wjblanke/moviecart/firmware/stm32/src/update.c

#include <string.h> // memset
#include "defines.h"
#include "osd.h"
#include "update.h"
#include "moviecart_yield.h"
#include "bus_service.h"

// transport controls

#define OSD_FRAMES		180
#define BACK_SECONDS	10

#define COLOR_BLACK		0x00
#define COLOR_BLUE		0x9A

#define LABEL_HEIGHT	14
#define LEVEL_HEIGHT	8
#define	TIMECODE_HEIGHT	12

// state machine
#define MODE_TIME       0
#define MODE_VOLUME     1
#define MODE_BRIGHT     2
#define MODE_LAST       MODE_BRIGHT	// last selectable mode; 3 was a dead mode (volume label, no controls)

#define MAX_LEVEL       11
/*
 * Fast-forward/rewind ceiling in fields per frame (speed climbs 1, 5, 9 ... 125
 * while the joystick is held). Each frame's forward seek runs inside the
 * RamKernel window; at 125 it costs at most about one FAT sector read.
 */
#define MAX_SPEED       125
#define DEFAULT_LEVEL   6

/*
 * Volume/brightness left-right: step on the first frame the stick is pushed,
 * then auto-repeat after LEVEL_REPEAT_DELAY frames every LEVEL_REPEAT_RATE.
 * (Waiting for the 16-frame joyRepeat wrap made quick taps never register.)
 */
#define LEVEL_REPEAT_DELAY	24
#define LEVEL_REPEAT_RATE	8


// scale adjustments, automatically generated
const uint8_t scale0[16] = { 8, 8, 8, 8, 8, 8, 8, 8, 8, 8, 8, 8, 8, 8, 8, 8 /*0.0000 */ };
const uint8_t scale1[16] = { 6, 6, 7, 7, 7, 7, 7, 7, 8, 8, 8, 8, 8, 8, 9, 9 /*0.1667 */ };
const uint8_t scale2[16] = { 5, 5, 6, 6, 6, 7, 7, 7, 8, 8, 8, 9, 9, 9, 10, 10 /*0.3333 */ };
const uint8_t scale3[16] = { 4, 4, 5, 5, 6, 6, 7, 7, 8, 8, 9, 9, 10, 10, 11, 11 /*0.5000 */ };
const uint8_t scale4[16] = { 3, 3, 4, 5, 5, 6, 7, 7, 8, 9, 9, 10, 11, 11, 12, 13 /*0.6667 */ };
const uint8_t scale5[16] = { 1, 2, 3, 4, 5, 5, 6, 7, 8, 9, 10, 10, 11, 12, 13, 14 /*0.8333 */ };
const uint8_t scale6[16] = { 0, 1, 2, 3, 4, 5, 6, 7, 8, 9, 10, 11, 12, 13, 14, 15 /*1.0000 */ };
const uint8_t scale7[16] = { 0, 0, 0, 1, 3, 4, 5, 7, 8, 10, 11, 12, 14, 15, 15, 15 /*1.3611 */ };
const uint8_t scale8[16] = { 0, 0, 0, 0, 1, 3, 5, 7, 8, 10, 12, 14, 15, 15, 15, 15 /*1.7778 */ };
const uint8_t scale9[16] = { 0, 0, 0, 0, 0, 2, 4, 6, 9, 11, 13, 15, 15, 15, 15, 15 /*2.2500 */ };
const uint8_t scale10[16] = { 0, 0, 0, 0, 0, 1, 3, 6, 9, 12, 14, 15, 15, 15, 15, 15 /*2.7778 */ };
//const uint8_t *scaleList[11] = { scale0, scale1, scale2, scale3, scale4, scale5, scale6, scale7, scale8, scale9, scale10 };
const uint8_t * const scaleList[11] = { scale0, scale1, scale2, scale3, scale4, scale5, scale6, scale7, scale8, scale9, scale10 };

struct updateInfo
{
	uint_fast8_t    mode;
	uint_fast8_t    drawLevelBars; // expressed in frames
	uint_fast8_t    drawTimeCode; // expressed in frames
	uint_fast8_t    volume;
	uint_fast8_t    bright;
	uint_fast8_t    joyRepeat;
	uint_fast8_t    levelRepeat;
	bool            right;
	bool            left;
	uint_fast8_t    lastMainMode;
	int8_t          speed;    // signed
	int8_t          step; // signed
	bool            lswcha_off;
	uint_fast8_t    linpt4;
	uint_fast8_t    lswchb;
};

__attribute__((section(".updateInfo"))) struct updateInfo           uInfo;

void
updateInit()
{
	moviecart_wait_ram_kernel_entry();
	uInfo.mode = MODE_TIME;
	uInfo.drawLevelBars = 0;
	uInfo.drawTimeCode = 0;
	uInfo.volume = DEFAULT_LEVEL;
#if MOVIECART_INIT_PHASE == 153
	emulate_cartridge();
#endif

	moviecart_wait_ram_kernel_entry();
	uInfo.bright = DEFAULT_LEVEL;
	uInfo.joyRepeat = 0x01;
	uInfo.levelRepeat = 0;
	uInfo.right = false;
	uInfo.left = false;
#if MOVIECART_INIT_PHASE == 154
	emulate_cartridge();
#endif

	moviecart_wait_ram_kernel_entry();
	uInfo.lastMainMode = 0xff;
	uInfo.speed = 1;
	uInfo.step = 1;
#if MOVIECART_INIT_PHASE == 155
	emulate_cartridge();
#endif

	moviecart_wait_ram_kernel_entry();
	uInfo.lswcha_off = true;
	uInfo.linpt4 = 0xff;
	uInfo.lswchb = 0xff;
}

void
updateTransport(struct stateVars *state)
{
	uInfo.lastMainMode = uInfo.mode;
	uInfo.right = !(state->i_swcha & 0x80);
	uInfo.left = !(state->i_swcha & 0x40);


	// reset
	if (!(state->i_swchb & 0x01) && (uInfo.lswchb & 0x01))
	{
		uInfo.drawTimeCode = OSD_FRAMES;
		state->io_frameNumber -= 60 *BACK_SECONDS;
	}

	uInfo.lswchb = state->i_swchb;

	// fire
	if (!(state->i_inpt4 & 0x80) && (uInfo.linpt4 & 0x80))
		state->io_bits ^= STATE_PLAYING;
	uInfo.linpt4 = state->i_inpt4;

	if (!(state->i_swcha & 0x10))	// up
	{
		if (uInfo.lswcha_off)
		{
			if (uInfo.mode == 0)
				uInfo.mode = MODE_LAST;
			else
				uInfo.mode--;
		}
	}

	if (!(state->i_swcha & 0x20))	// down
	{
		if (uInfo.lswcha_off)
		{
			if (uInfo.mode == MODE_LAST)
				uInfo.mode = 0;
			else
				uInfo.mode++;
		}
	}

	if (uInfo.left || uInfo.right)
	{
		uInfo.joyRepeat++;
		uInfo.joyRepeat &= 0x0f;
		if (++uInfo.levelRepeat > LEVEL_REPEAT_DELAY)
			uInfo.levelRepeat = LEVEL_REPEAT_DELAY - LEVEL_REPEAT_RATE + 1;
	}
	else
	{
		uInfo.joyRepeat = 0x01;
		uInfo.levelRepeat = 0;
		uInfo.speed = 1;
	}

	bool levelStep = (uInfo.levelRepeat == 1 ||
	    uInfo.levelRepeat == LEVEL_REPEAT_DELAY);

	if (!uInfo.joyRepeat)
	{
		if (uInfo.mode == MODE_TIME)
		{
			uInfo.drawTimeCode = OSD_FRAMES;
			if (uInfo.speed <= MAX_SPEED - 4)
				uInfo.speed += 4;
		}
	}

	if (levelStep)
	{
		if (uInfo.mode == MODE_VOLUME)
		{
			uInfo.drawLevelBars = OSD_FRAMES;
			if (uInfo.left)
			{
				if (uInfo.volume)
					uInfo.volume--;
			}
			else
			{
				uInfo.volume++;
				if (uInfo.volume >= MAX_LEVEL)
					uInfo.volume--;
			}
		}
	}

	if (levelStep)
	{
		if (uInfo.mode == MODE_BRIGHT)
		{
			uInfo.drawLevelBars = OSD_FRAMES;
			if (uInfo.left)
			{
				if (uInfo.bright)
					uInfo.bright--;
			}
			else
			{
				uInfo.bright++;
				if (uInfo.bright >= MAX_LEVEL)
					uInfo.bright--;
			}
		}
	}

	switch (uInfo.mode)
	{
		case MODE_TIME:
			if (uInfo.lastMainMode != uInfo.mode)
				uInfo.drawTimeCode = OSD_FRAMES;
			break;

		case MODE_BRIGHT:
		case MODE_VOLUME:
		default:
			if (uInfo.lastMainMode != uInfo.mode)
				uInfo.drawLevelBars = OSD_FRAMES;
			break;
	}

	// just draw one
	if (uInfo.drawLevelBars > uInfo.drawTimeCode)
		uInfo.drawTimeCode = 0;
	else
		uInfo.drawLevelBars = 0;

	// update frame
	uInfo.step = (state->io_frameNumber & 1) ? -1 : 1; // signed

	if (!(state->io_bits & STATE_PLAYING))	// step while paused, repeating while held
	{
		if (uInfo.mode == MODE_TIME)
		{
			if (levelStep)
			{
				if (uInfo.right)
					uInfo.step = 2;
				else if (uInfo.left)
					uInfo.step = -2;
			}
		}
	}

	if (state->io_bits & STATE_PLAYING)
	{
		uInfo.step = 1;
		if (uInfo.mode == MODE_TIME)
		{
			if (uInfo.right)
				uInfo.step = uInfo.speed;
			else if (uInfo.left)
				uInfo.step = -uInfo.speed;
		}
	}

	uInfo.lswcha_off = !(~state->i_swcha & 0xff);
	state->io_frameNumber += uInfo.step;

	// check negative before unsigned comparison below
	if (state->io_frameNumber < 0)
	{
		state->io_frameNumber = (state->io_frameNumber & 1) ? 1 : 0;
		state->io_bits |= STATE_MUTE0;
		state->io_bits |= STATE_MUTE1;
	}

	if (state->i_numFrames && (state->io_frameNumber >= state->i_numFrames))
	{
		state->io_frameNumber = (state->io_frameNumber & 1) ? state->i_numFrames-1 : state->i_numFrames-2;
		state->io_bits |= STATE_MUTE0;
		state->io_bits |= STATE_MUTE1;
		state->io_bits |= STATE_END;
	};
}

/*
 * Make bit 0 of the next frame number equal low, moving one more field the way
 * the transport moved (or back, at either end). Once a file's field parity is
 * in step with the RamKernel's, playing and paused stepping both alternate it,
 * so this only fires after a start, a seek, or a missed frame.
 */
void
updateFieldParity(struct stateVars* state, int32_t prevFrame, uint8_t low)
{
	int32_t	dir;
	int32_t	n;

	if ((uint8_t)(state->io_frameNumber & 1) == low || state->i_numFrames < 2)
		return;

	dir = (state->io_frameNumber < prevFrame) ? -1 : 1;
	n = state->io_frameNumber + dir;
	if (n < 0 || (uint32_t)n >= state->i_numFrames)
		n = state->io_frameNumber - dir;
	state->io_frameNumber = n;
}

void
updateVolume(struct stateVars* state, struct frameInfo* fInfo)
{
	const uint8_t*  volumeScale;

	if (state->io_bits & STATE_MUTE0)
	{
		volumeScale = scaleList[0];
		state->io_bits &= ~STATE_MUTE0;
	}
	else if (state->io_bits & STATE_MUTE1)
	{
		volumeScale = scaleList[0];
		state->io_bits &= ~STATE_MUTE1;
	}
	else
	{
		if (state->io_bits & STATE_PLAYING)
			volumeScale = scaleList[uInfo.volume];
		else
			volumeScale = scaleList[0];
	}


	uint_fast16_t	t = fInfo->totalLines;
	uint8_t*		dst = fInfo->audioBuf;

	while(t)
	{
		*dst = volumeScale[*dst & 0x0F];
		dst++;
		t--;
		if (!(t & 3u))
			moviecart_bus_yield();
	};
}

// lower bit is ignored anyways
const uint8_t shiftBright[16 + MAX_LEVEL - 1] = { 0, 0, 0, 0, 0, 0, 0, 1, 2, 3, 4, 5, 6, 7, 8, 9, 10, 11, 12, 13, 14, 15, 15, 15, 15, 15 };

void
updateColor(struct stateVars* state, struct frameInfo* fInfo)
{
	uint8_t		colorMask;
	uint_fast16_t	t;
	uint8_t*		dst;

	// color
	if (state->i_swchb & 0x08)
		colorMask = 0xff;
	else
		colorMask = 0x0f;

	uint8_t	lines = fInfo->visibleLines;

	const uint_fast16_t	offset22 = (fInfo->visibleLines - (LABEL_HEIGHT+LEVEL_HEIGHT))*5;
	const uint_fast16_t	offsetTC = (fInfo->visibleLines - TIMECODE_HEIGHT)*5;

	if (uInfo.drawLevelBars)
	{
		uInfo.drawLevelBars--;
		lines -= (LABEL_HEIGHT + LEVEL_HEIGHT);

		uint8_t levelValue;
		const uint8_t*	srcLabel;
		const uint8_t*	srcLevel;

		if (uInfo.mode == MODE_BRIGHT)
		{
			levelValue = uInfo.bright;
			if (fInfo->odd)
				srcLabel = brightLabelOdd;
			else
				srcLabel = brightLabelEven;
		}
		else
		{
			levelValue = uInfo.volume;
			if (fInfo->odd)
				srcLabel = volumeLabelOdd;
			else
				srcLabel = volumeLabelEven;
		}

		if (fInfo->odd)
			srcLevel = &levelBarsOddData[levelValue * 40];
		else
			srcLevel = &levelBarsEvenData[levelValue * 40];

		const uint_fast16_t	offset1 = (fInfo->visibleLines - (LABEL_HEIGHT+LEVEL_HEIGHT))*1;

		// background
		{
			uint8_t *p = fInfo->colorBuf + offset22;
			uint_fast16_t n = (LABEL_HEIGHT+LEVEL_HEIGHT)*5;
			while (n) {
				*p++ = COLOR_BLUE;
				n--;
				if (!(n & 7u))
					moviecart_bus_yield();
			}
		}
		{
			uint8_t *p = fInfo->colorBKBuf + offset1;
			uint_fast16_t n = (LABEL_HEIGHT+LEVEL_HEIGHT)*1;
			while (n) {
				*p++ = COLOR_BLACK;
				n--;
				if (!(n & 7u))
					moviecart_bus_yield();
			}
		}

		// label
		{
			uint8_t *d = fInfo->graphBuf + offset22;
			const uint8_t *s = srcLabel;
			uint_fast16_t n = LABEL_HEIGHT*5;
			while (n) {
				*d++ = *s++;
				n--;
				if (!(n & 7u))
					moviecart_bus_yield();
			}
		}

		// level
		const uint_fast16_t offsetG = (fInfo->visibleLines - LEVEL_HEIGHT)*5;
		{
			uint8_t *d = fInfo->graphBuf + offsetG;
			const uint8_t *s = srcLevel;
			uint_fast16_t n = LEVEL_HEIGHT*5;
			while (n) {
				*d++ = *s++;
				n--;
				if (!(n & 7u))
					moviecart_bus_yield();
			}
		}
	}
	else if (uInfo.drawTimeCode)
	{
		uInfo.drawTimeCode--;
		lines -= TIMECODE_HEIGHT;

		const uint_fast16_t	offset1 = (fInfo->visibleLines - TIMECODE_HEIGHT)*1;

		{
			uint8_t *d = fInfo->graphBuf + offsetTC;
			const uint8_t *s = fInfo->timecodeBuf;
			uint_fast16_t n = TIMECODE_HEIGHT*5;
			while (n) {
				*d++ = *s++;
				n--;
				if (!(n & 7u))
					moviecart_bus_yield();
			}
		}
		{
			uint8_t *p = fInfo->colorBuf + offsetTC;
			uint_fast16_t n = TIMECODE_HEIGHT*5;
			while (n) {
				*p++ = COLOR_BLUE;
				n--;
				if (!(n & 7u))
					moviecart_bus_yield();
			}
		}
		{
			uint8_t *p = fInfo->colorBKBuf + offset1;
			uint_fast16_t n = TIMECODE_HEIGHT*1;
			while (n) {
				*p++ = COLOR_BLACK;
				n--;
				if (!(n & 7u))
					moviecart_bus_yield();
			}
		}
	}

	// foreground
	dst = fInfo->colorBuf;
	t = lines * 5;

	while(t)
	{
		uint8_t r_data = *dst;
		*dst++ = ((r_data & 0xf0) | shiftBright[(r_data & 0x0f) + uInfo.bright]) & colorMask;
		t--;
		if (!(t & 3u))
			moviecart_bus_yield();
	};

	// background
	t = lines * 1;
	dst = fInfo->colorBKBuf;
	while(t)
	{
		uint8_t r_data = *dst;
		*dst++ = ((r_data & 0xf0) | shiftBright[(r_data & 0x0f) + uInfo.bright]) & colorMask;
		t--;
		if (!(t & 3u))
			moviecart_bus_yield();
	};

	// square off edges
	const uint_fast16_t	offsetF = (fInfo->visibleLines*5);
	if (fInfo->odd)
	{
		// bottom line
		fInfo->colorBuf[offsetF - 5] = COLOR_BLACK;
		fInfo->colorBuf[offsetF - 4] = COLOR_BLACK;
		fInfo->colorBuf[offsetF - 3] = COLOR_BLACK;
		fInfo->colorBuf[offsetF - 2] = COLOR_BLACK;
		fInfo->colorBuf[offsetF - 1] = COLOR_BLACK;

	}
	else
	{
		// top line
		fInfo->colorBuf[0] = COLOR_BLACK;
		fInfo->colorBuf[1] = COLOR_BLACK;
		fInfo->colorBuf[2] = COLOR_BLACK;
		fInfo->colorBuf[3] = COLOR_BLACK;
		fInfo->colorBuf[4] = COLOR_BLACK;
	}

	fInfo->colorBKBuf[0] = 0;

	// flat black line above time code
	if (uInfo.drawTimeCode)
	{
		uint8_t	*d = fInfo->odd ? (fInfo->graphBuf + offsetTC - 5) : (fInfo->graphBuf + offsetTC - 0);
		*d++ = 0;
		*d++ = 0;
		*d++ = 0;
		*d++ = 0;
		*d++ = 0;
	}

	// flat black line above label
	if (uInfo.drawLevelBars)
	{
		uint8_t	*d = fInfo->odd ? (fInfo->graphBuf + offset22 - 5) : (fInfo->graphBuf + offset22 - 0);
		*d++ = 0;
		*d++ = 0;
		*d++ = 0;
		*d++ = 0;
		*d++ = 0;
	}

}

void
updateBuffer(struct stateVars* state, struct frameInfo* fInfo)
{
	updateVolume(state, fInfo);
	updateColor(state, fInfo);
}

/**
 End of File
*/
