wjblanke/moviecart/firmware/stm32/src/title_data.c

#include <stdint.h>
#include "title_data.h"

const uint8_t TitleGraph1[960] = {
	0x00, 0x00, 0x00, 0x00, 0x00, 0xff, 0x48, 0x64, 0x07, 0x1f, 0xe2, 0xc9, 0xfc, 0x19, 0xff, 0xff,
	0xa6, 0xdb, 0x04, 0x07, 0x4d, 0x9e, 0xfe, 0x3f, 0xe0, 0xff, 0x58, 0x7f, 0x0e, 0x39, 0x88, 0x60,
	0xcd, 0xa6, 0xff, 0x6f, 0x37, 0xff, 0xe0, 0x03, 0xdf, 0xf0, 0x92, 0xd9, 0xfb, 0xff, 0xc9, 0xf6,
	0x3f, 0x07, 0x1f, 0x03, 0xff, 0x7f, 0xf0, 0x1f, 0x03, 0xfd, 0x7c, 0x0f, 0x1f, 0xff, 0xff, 0xdf,
	0xb6, 0xfb, 0xf0, 0x7f, 0x48, 0xc0, 0x78, 0x3e, 0xf8, 0x3f, 0xff, 0xb2, 0x03, 0x0f, 0x87, 0xff,
	0x7c, 0x93, 0x83, 0xc4, 0xdb, 0xff, 0xc8, 0x30, 0x6c, 0x3e, 0x7c, 0xca, 0xc3, 0xc0, 0x59, 0xff,
	0x27, 0x87, 0x93, 0xed, 0x78, 0x81, 0xc3, 0x23, 0x7f, 0xb6, 0x07, 0xc7, 0xc7, 0xe1, 0x86, 0xcb,
	0xe7, 0xcc, 0x49, 0xb6, 0x27, 0xc7, 0xd3, 0xf3, 0x8e, 0xc3, 0xe7, 0xc4, 0x49, 0x34, 0x37, 0xc7,
	0xd7, 0x73, 0x61, 0x83, 0xe7, 0xc0, 0x6d, 0xb4, 0x27, 0xe7, 0xdb, 0x79, 0x63, 0x3c, 0xc3, 0x33,
	0x6f, 0xfc, 0x88, 0xc7, 0x3c, 0xc6, 0xe3, 0x7e, 0x18, 0x1b, 0xff, 0xff, 0xf0, 0x03, 0x00, 0xff,
	0x03, 0xff, 0xff, 0xff, 0x3d, 0xfc, 0xff, 0xff, 0xff, 0xe0, 0xf8, 0xff, 0xff, 0xff, 0xff, 0xbc,
	0xff, 0xff, 0xff, 0xe0, 0x0f, 0xff, 0xff, 0xff, 0x3d, 0xf9, 0xff, 0xff, 0xff, 0xf0, 0xf0, 0x00,
	0x00, 0x00, 0xff, 0x9f, 0x7e, 0xff, 0xf1, 0xfe, 0xe3, 0xc0, 0x00, 0x00, 0xff, 0xff, 0xc3, 0x00,
	0x0e, 0x07, 0x43, 0xc0, 0x00, 0x00, 0xff, 0xff, 0xc3, 0x00, 0x00, 0x03, 0x83, 0xc0, 0x00, 0x00,
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
	0x02, 0x02, 0x02, 0x02, 0x04, 0x02, 0x02, 0x06, 0x02, 0x0a, 0x02, 0x02, 0x02, 0x02, 0x02, 0x02,
	0x02, 0x02, 0x04, 0x02, 0x04, 0x02, 0x02, 0x02, 0x02, 0x06, 0x02, 0x06, 0x02, 0x08, 0x00, 0x02,
	0x06, 0x02, 0x02, 0x02, 0x02, 0x02, 0x02, 0x02, 0x02, 0x02, 0x00, 0x02, 0x00, 0x00, 0x00, 0x00,
};
