wjblanke/moviecart/firmware/stm32/src/title_data.h

#ifndef TITLE_DATA_H
#define TITLE_DATA_H
#include <stdint.h>

extern const uint8_t TitleGraph1[960];
extern const uint8_t TitleGraph2[960];
extern const uint8_t TitleColor1[960];
extern const uint8_t TitleColor2[960];
extern const uint8_t TitleBackColor1[192];
extern const uint8_t TitleBackColor2[192];

#endif
