wjblanke/moviecart/(commit log)

2026-08-10 initial stm32 code
2026-08-10 movie cart logo at least, 3 led blinks
2026-08-12 base good. stage2 ok. full kinda messed up
2026-08-12 led working 7 blinks
2026-09-01 multiblock dma
2026-09-01 split dma init and finish across whole frame
2026-09-02 update test to current ramkernel
